nottelegraham/sentinel-glance-ghl/case/glance_stand_preview.png

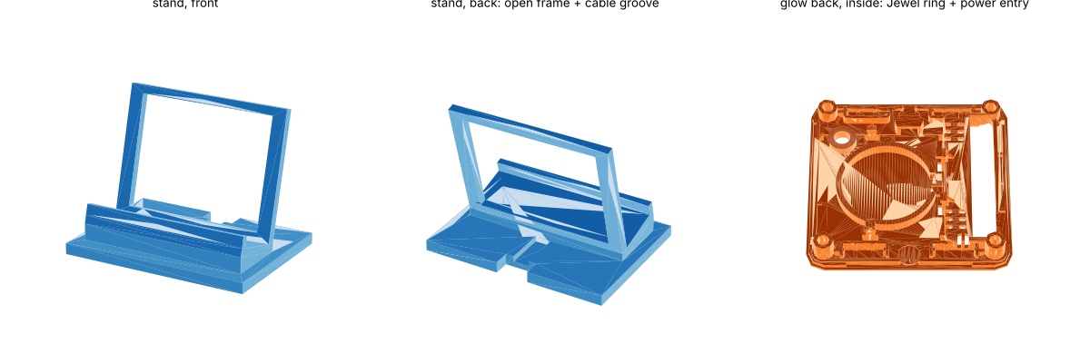
case/glance_stand_preview.png
