nottelegraham/sentinel-glance-ghl/case/glance_back.stl

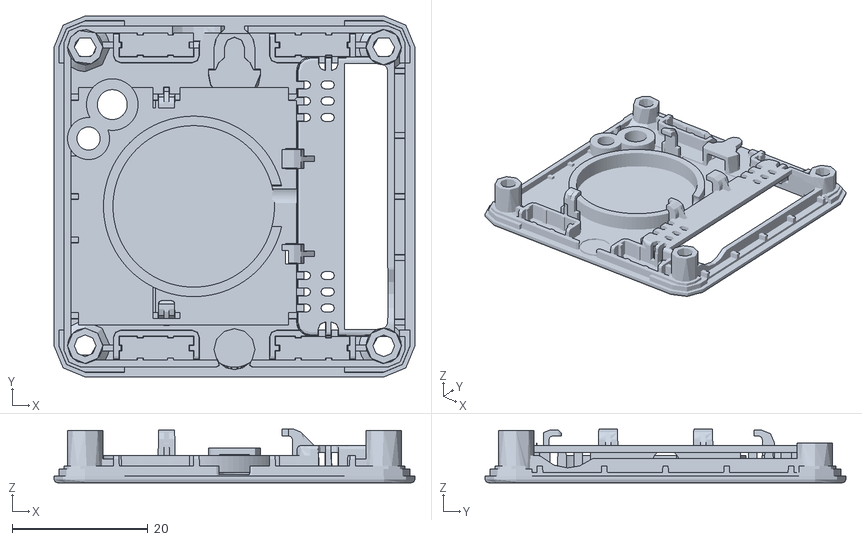
[picture p2: CAD file, 2026-11-10]
case/glance_back.stl
53.2 x 53.2 x 7.90
