nottelegraham/sentinel-glance-ghl/case/glance_battery_cover.stl

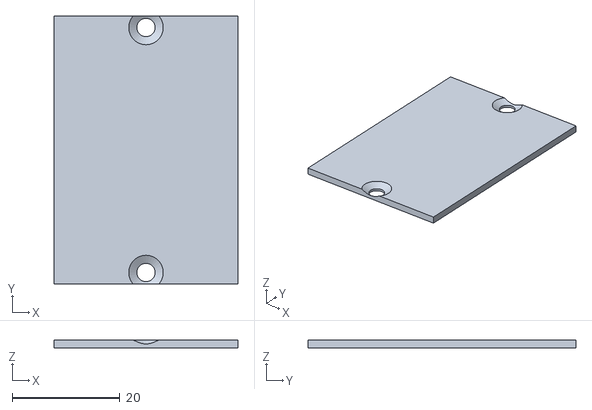
[picture p3: CAD file, 2026-11-10]
case/glance_battery_cover.stl
34.1 x 49.6 x 1.50
