nottelegraham/sentinel-glance-ghl/case/glance_stand.stl

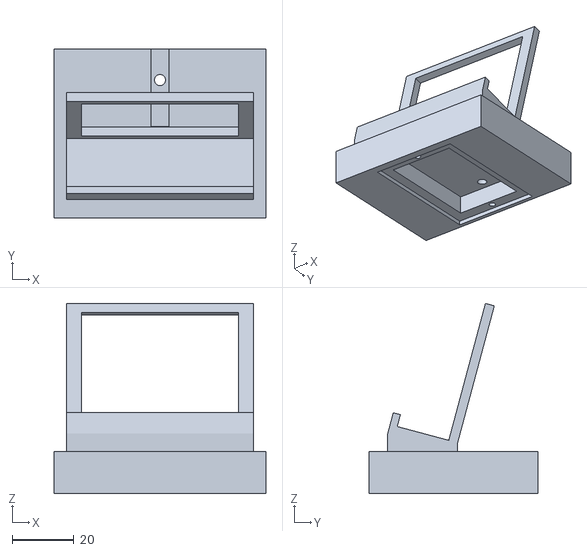
[picture p4: CAD file, 2026-11-10]
case/glance_stand.stl
68.8 x 54.7 x 61.7
