nottelegraham/sentinel-glance-ghl/(commit log)

2026-11-10 Sentinel Glance – GHL v0.5.0
    M5Stack Core2 four-tile display for GHL ProfiLux controllers (Mini, Light
    Wi-Fi, ProfiLux 4) and the Master Doser 2.1, up to six devices, read-only.
    Adds per-doser pump settings, Sensor N readings, alarm masks, OTA from the
    setup page (upload or latest GitHub release) and a CI build that attaches
    firmware.bin to tagged releases.
    Claude-Session: https://claude.ai/code/session_015pgDPGcvaYUHTy86VRsMJe
    [glance_back.stl, glance_battery_cover.stl, glance_stand.stl]
2026-11-10 License: PolyForm Noncommercial, no resale without permission; glow back optional
    Default power input is now USB-C; glow back builders switch it on the setup page.
    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
2026-11-10 README: glow back optional, license section; default power input USB-C
    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
